sotechcllc/RFDoorLock/README.md

# RFDoorLock
Repo. for the RFID DoorLock project
