sotechcllc/RFDoorLock/Hardware/Diagrams/Circuit.png

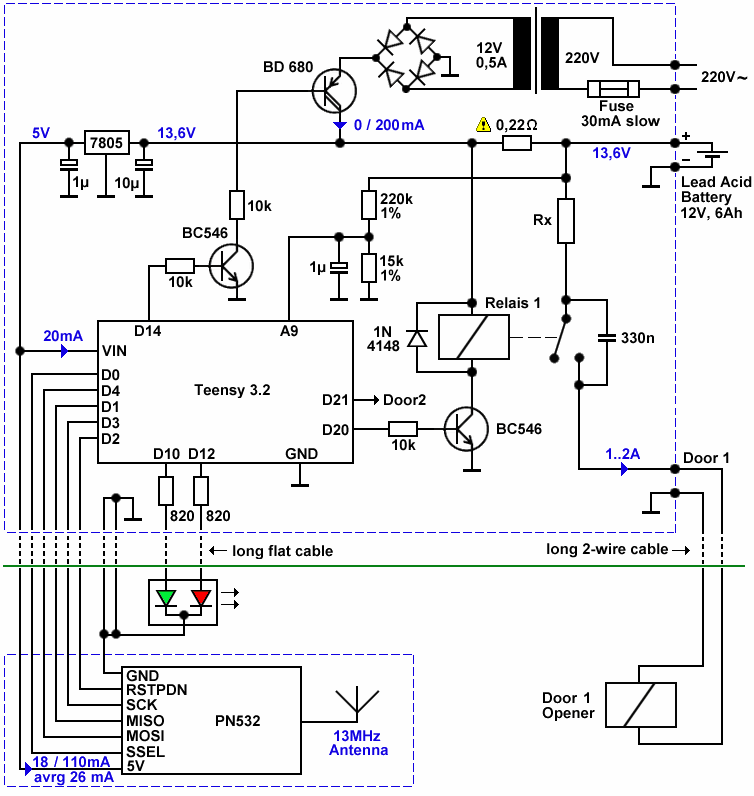
Hardware/Diagrams/Circuit.png
