sotechcllc/RFDoorLock/Hardware/Diagrams/Board for manual soldering/Board (Parts and Grid).png

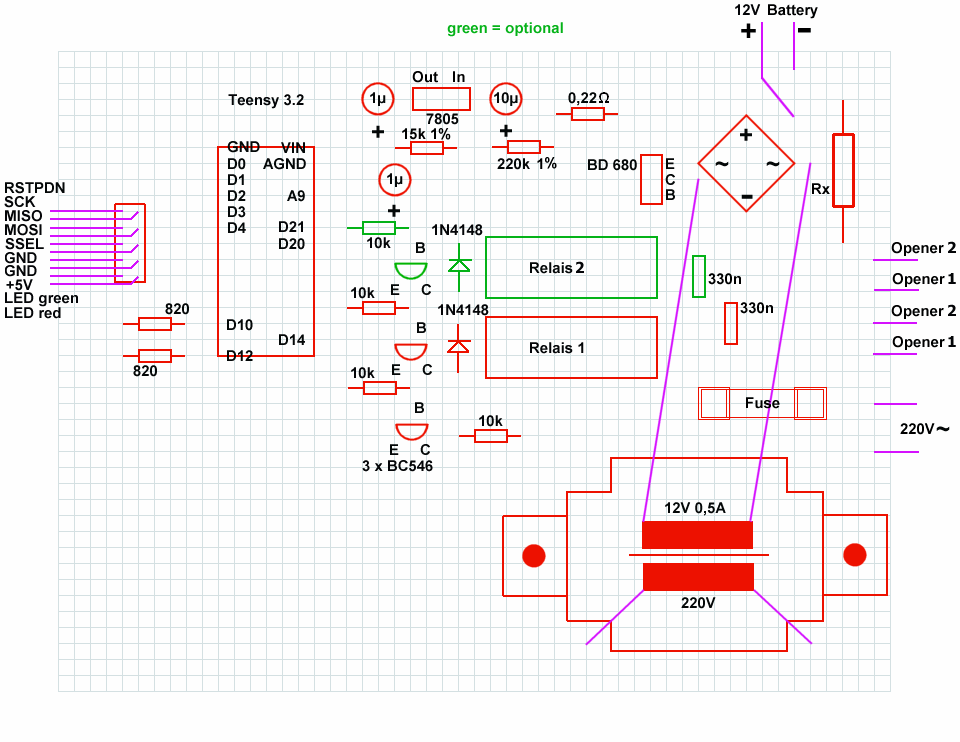
Hardware/Diagrams/Board for manual soldering/Board (Parts and Grid).png
