sotechcllc/RFDoorLock/Hardware/Diagrams/Board for manual soldering/Board (All).png

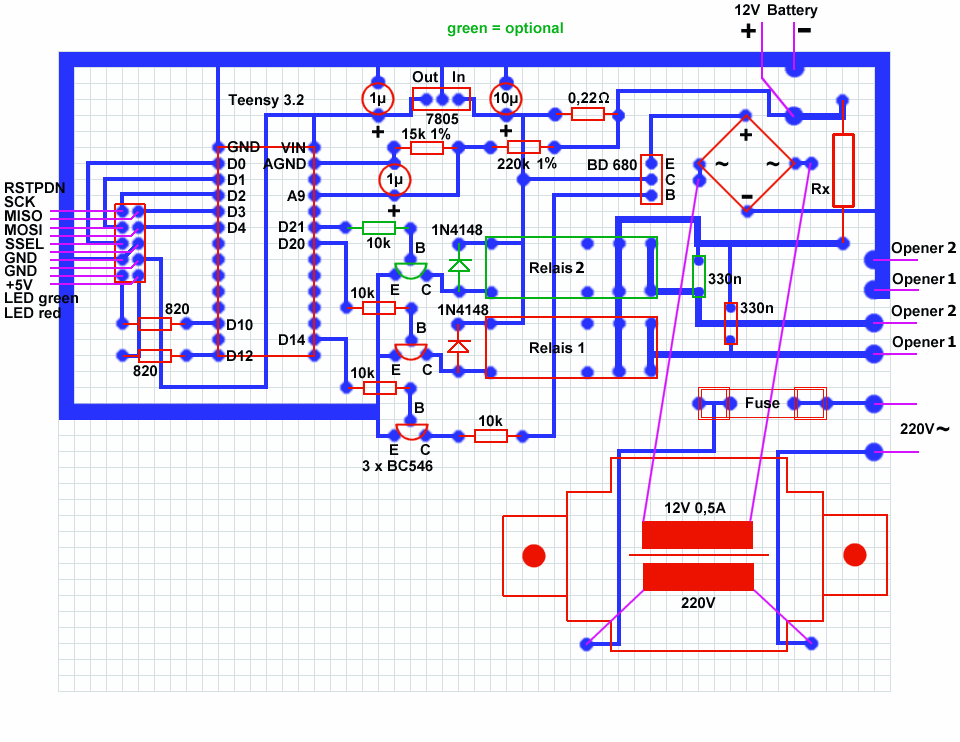
Hardware/Diagrams/Board for manual soldering/Board (All).png
