sotechcllc/RFDoorLock/Hardware/Diagrams/Board for manual soldering/Board (Pathway and Grid).png

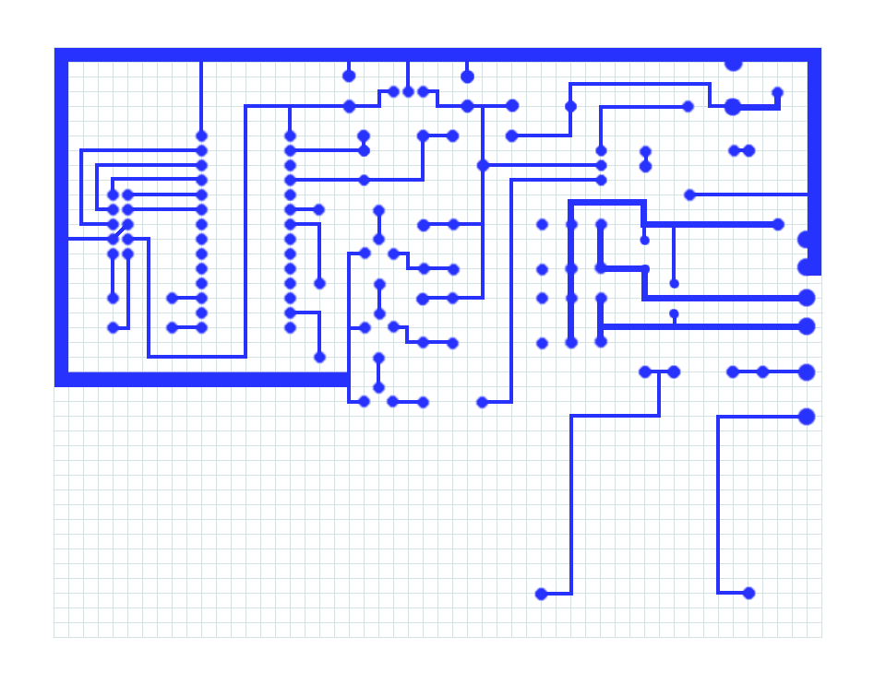
Hardware/Diagrams/Board for manual soldering/Board (Pathway and Grid).png
