sotechcllc/RFDoorLock/Hardware/Diagrams/Board for manual soldering/Board (Pathway only).png

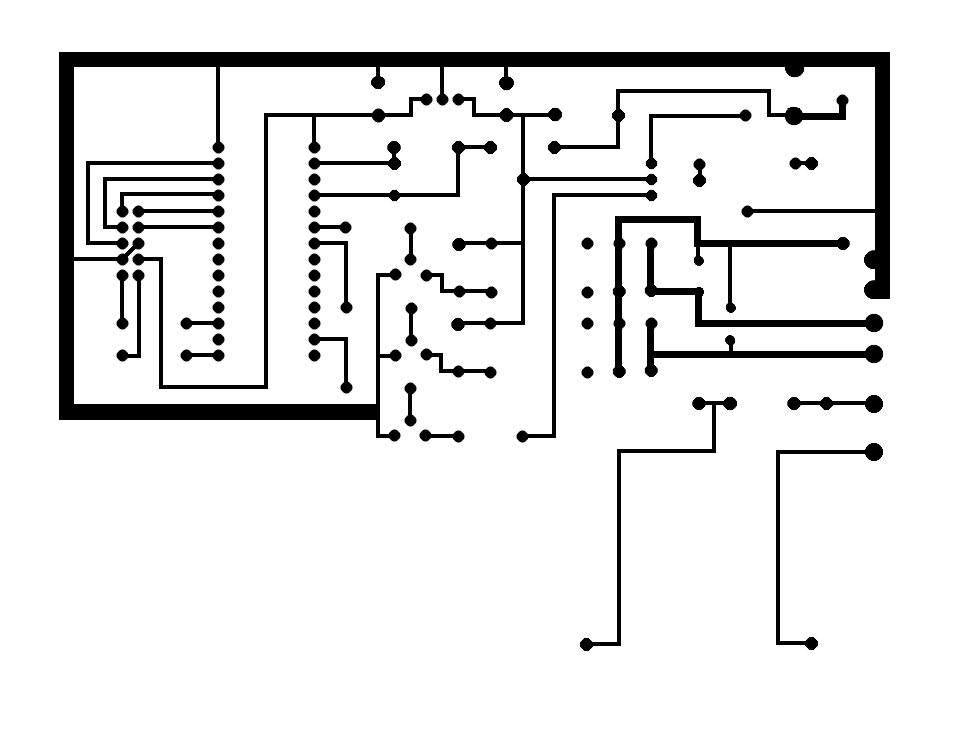
Hardware/Diagrams/Board for manual soldering/Board (Pathway only).png
