sotechcllc/RFDoorLock/Hardware/Diagrams/Board for PCB production (Eagle v7.6)/RFID-Lock.brd

## EAGLE design Hardware/Diagrams/Board for PCB production (Eagle v7.6)/RFID-Lock.brd (2017-03-13)

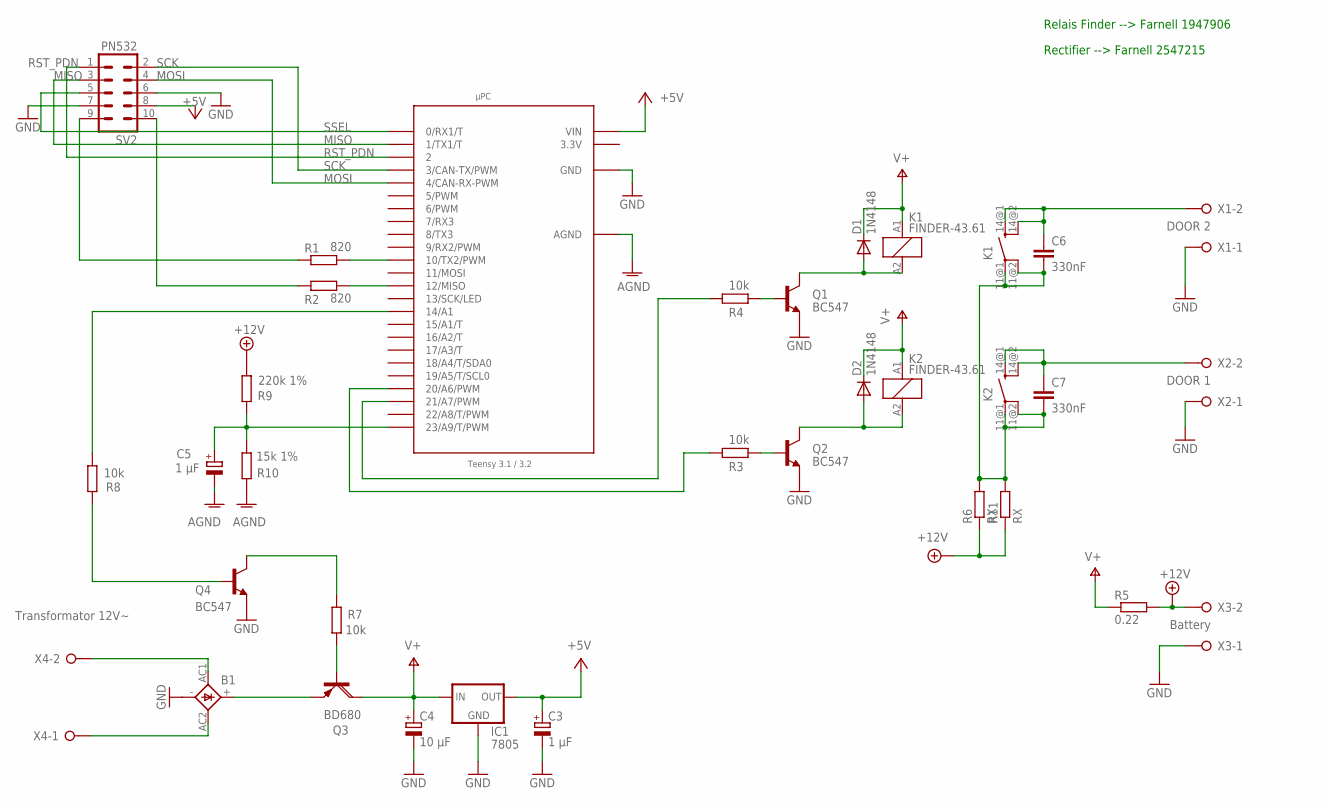
[picture p8: schematic RFID-Lock.sch]

Parts:
B1: GBPC6
C3, C5: 1 µF; E2,5-5
C4: 10 µF; E2,5-5
C6, C7: 330nF; C5B4.5
D1, D2: 1N4148; DO35-7
IC1: 7805; 78XXS
K1, K2: FINDER-43.61
Q1, Q2, Q4: BC547; TO92
Q3: BD680; TO126AV
R1, R2: 820; 0204/7
R3, R4, R7, R8: 10k; 0204/7
R5: 0.22; 0204/7
R6, R11: RX; P0613/15
R9: 220k 1%; 0204/7
R10: 15k 1%; 0204/7
SV2: PN532; MA05-2
X1: DOOR 2; W237-132
X2: DOOR 1; W237-132
X3: Battery; W237-132
X4: Transformator 12V~; W237-132
µPC: Teensy 3.1 / 3.2; TEENSY3-DIL

Connections:
3.3V: µPC.3.3V
+5V: C3.+, IC1.OUT, SV2.8, µPC.VIN
+12V: R5.2, R6.1, R9.2, R11.1, X3.2
AGND: C5.-, R10.1, µPC.AGND
DOOR2: C6.1, K1.14@1 (SA), K1.14@2 (SB), X1.2
GND: B1.-, C3.-, C4.-, IC1.GND, Q1.1 (E), Q2.1 (E), Q4.1 (E), SV2.6, SV2.7, X1.1, X2.1, X3.1, µPC.GND
LED-GREEN: R1.1, SV2.9
LED-RED: R2.1, SV2.10
MISO: SV2.3, µPC.1 (1/TX1/T)
MOSI: SV2.4, µPC.4 (4/CAN-RX-PWM)
unnamed: Q3.B, R7.1
unnamed: Q4.3 (C), R7.2
unnamed: R1.2, µPC.10 (10/TX2/PWM)
unnamed: R2.2, µPC.12 (12/MISO)
unnamed: B1.AC1, X4.2
unnamed: D2.A, K2.A2 (2), Q2.3 (C)
unnamed: Q4.2 (B), R8.1
unnamed: C7.1, K2.14@1 (SA), K2.14@2 (SB), X2.2
unnamed: D1.A, K1.A2 (2), Q1.3 (C)
unnamed: Q1.2 (B), R4.2
unnamed: Q2.2 (B), R3.2
unnamed: R4.1, µPC.21/A7 (21/A7/PWM)
unnamed: R3.1, µPC.20/A6 (20/A6/PWM)
unnamed: B1.+, Q3.E
unnamed: B1.AC2, X4.1
unnamed: C6.2, C7.2, K1.11@1 (PA), K1.11@2 (PB), K2.11@1 (PA), K2.11@2 (PB), R6.2, R11.2
unnamed: R8.2, µPC.14/A0 (14/A1)
unnamed: C5.+, R9.1, R10.2, µPC.23/A9 (23/A9/T/PWM)
RST_PDN: SV2.1, µPC.2
SCK: SV2.2, µPC.3 (3/CAN-TX/PWM)
SSEL: SV2.5, µPC.0 (0/RX1/T)
V+: C4.+, D1.C, D2.C, IC1.IN, K1.A1 (1), K2.A1 (1), Q3.C, R5.1

Notes on the sheet:
Relais Finder --> Farnell 1947906
Rectifier --> Farnell 2547215

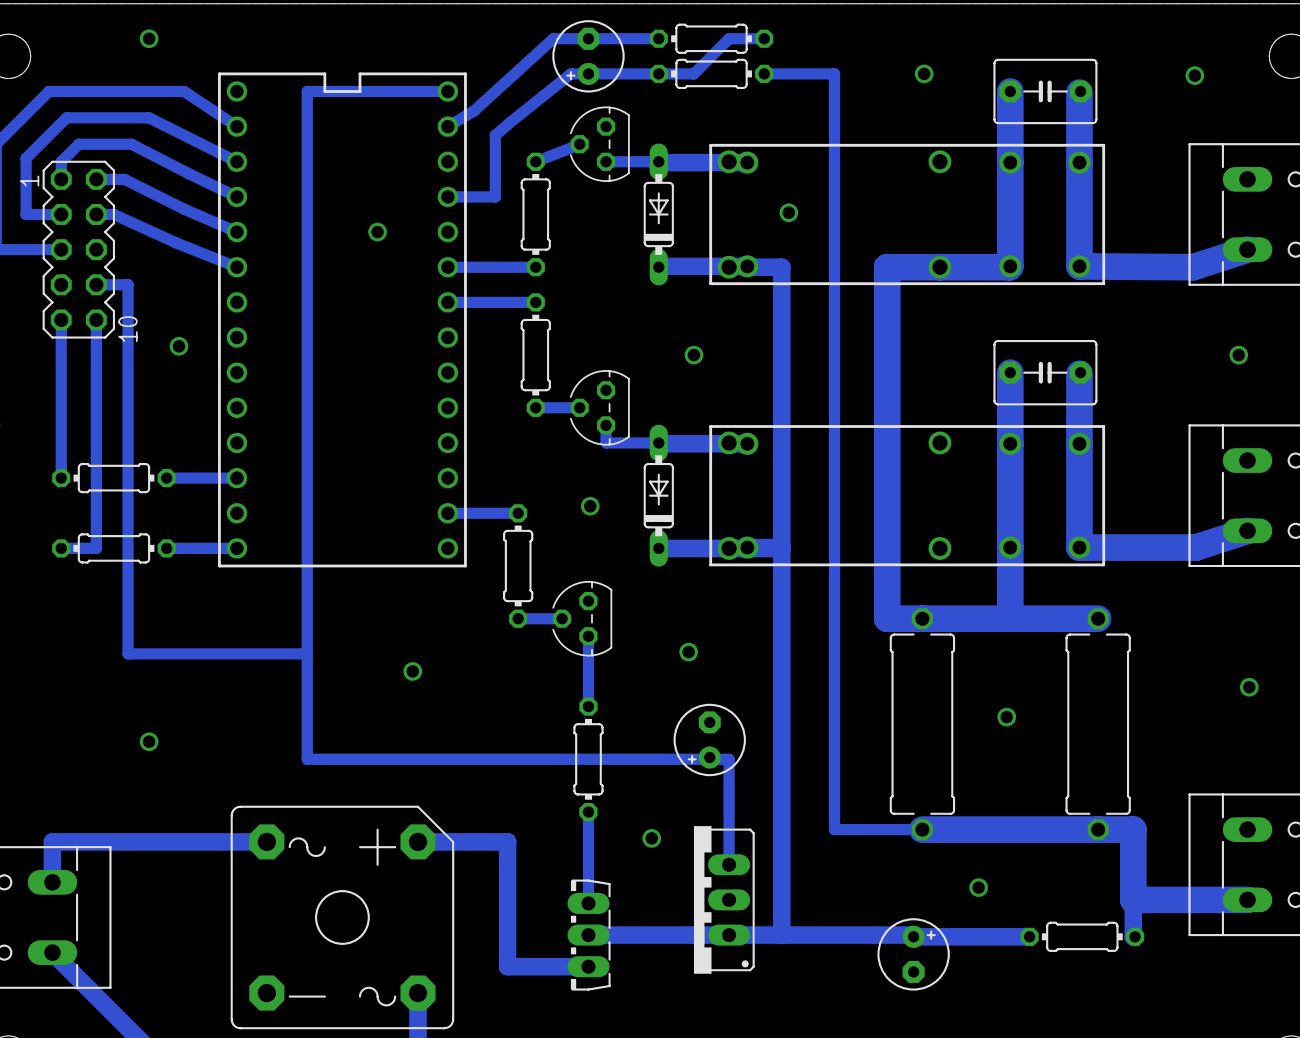
[picture p9: board RFID-Lock.brd from above]

Board: 2 copper layers, 32 parts (0 on the bottom side), 31 nets.
