sotechcllc/RFDoorLock/Software/WICED Feather/DoorOpenerSketchWICED/EEPROM.h

/*
  EEPROM.h - EEPROM library
  Version 1.0 Original Copyright (c) 2006 David A. Mellis.  All right reserved.
  Version 2.0 Copyright (c) 2015 Christopher Andrews.  All right reserved.
  This library is free software; you can redistribute it and/or
  modify it under the terms of the GNU Lesser General Public
  License as published by the Free Software Foundation; either
  version 2.1 of the License, or (at your option) any later version.
  This library is distributed in the hope that it will be useful,
  but WITHOUT ANY WARRANTY; without even the implied warranty of
  MERCHANTABILITY or FITNESS FOR A PARTICULAR PURPOSE.  See the GNU
  Lesser General Public License for more details.
  You should have received a copy of the GNU Lesser General Public
  License along with this library; if not, write to the Free Software
  Foundation, Inc., 51 Franklin St, Fifth Floor, Boston, MA  02110-1301  USA
*/

#if defined(__AVR__) && !defined(EEPROM_h)
  #define EEPROM_h

#ifndef Arduino_h  //These includes are available through Arduino.h
  #include <inttypes.h>
  #include <avr/io.h>
#endif
#include <avr/eeprom.h>

/***
    This provides a method of generating compile time errors in C++98 (#error is unsuitable).
    C++11 includes static_assert as a language construct.
***/
#if __cplusplus < 201103L || !defined(__GXX_EXPERIMENTAL_CXX0X__)
  #ifndef static_assert
    namespace COMPILE{
      template< bool > struct ERROR;
      template<> struct ERROR< true >{};
    };
    #define static_assert( cond, msg ) { COMPILE::ERROR<!!(cond)> msg; (void) msg; }    
  #endif
#else
  #define READING_POINTERS_DISABLED_FOR_EEPROM_GET  "Storing or reading a single pointer object has been disabled in EEPROM.get() and EEPROM.put(). " \
                                                    "Add a third parameter (count of elements) to use put() and get() on blocks of data. "            \
                                                    "The count is 'elements' not bytes of data."
  #define STORING_POINTERS_DISABLED_FOR_EEPROM_PUT READING_POINTERS_DISABLED_FOR_EEPROM_GET
#endif

/***
    EERef class.
    
    This object references an EEPROM cell.
    Its purpose is to mimic a typical byte of RAM, however its storage is the EEPROM.
    This class has an overhead of two bytes, similar to storing a pointer to an EEPROM cell.
***/

struct EEBit; //Forward declaration for EERef::opreator[]
struct EEPtr; //Forward declaration for EERef::opreator&

struct EERef{

    template< typename T > EERef( T *ptr ) : index( (int) ptr ) {}
    EERef( const int index ) : index( index )                   {}
    
    //Access/read members.
    uint8_t operator*() const            { return eeprom_read_byte( (uint8_t*) index ); }
    operator const uint8_t() const       { return **this; }
    EEBit operator[]( const int bidx );  //Defined below EEBit
    EEPtr operator&() const;             //Defined below EEPtr
    
    //Assignment/write members.
    EERef &operator=( const EERef &ref ) { return *this = *ref; }
    EERef &operator=( uint8_t in )       { return eeprom_write_byte( (uint8_t*) index, in ), *this; }
    EERef &operator +=( uint8_t in )     { return *this = **this + in; }
    EERef &operator -=( uint8_t in )     { return *this = **this - in; }
    EERef &operator *=( uint8_t in )     { return *this = **this * in; }
    EERef &operator /=( uint8_t in )     { return *this = **this / in; }
    EERef &operator ^=( uint8_t in )     { return *this = **this ^ in; }
    EERef &operator %=( uint8_t in )     { return *this = **this % in; }
    EERef &operator &=( uint8_t in )     { return *this = **this & in; }
    EERef &operator |=( uint8_t in )     { return *this = **this | in; }
    EERef &operator <<=( uint8_t in )    { return *this = **this << in; }
    EERef &operator >>=( uint8_t in )    { return *this = **this >> in; }
    
    EERef &update( uint8_t in )          { return  in != *this ? *this = in : *this; }
    
    /** Prefix increment/decrement **/
    EERef& operator++()                  { return *this += 1; }
    EERef& operator--()                  { return *this -= 1; }
    
    /** Postfix increment/decrement **/
    uint8_t operator++ (int){ 
        uint8_t ret = **this;
        return ++(*this), ret;
    }

    uint8_t operator-- (int){ 
        uint8_t ret = **this;
        return --(*this), ret;
    }
    
    int index; //Index of current EEPROM cell.
};

/***
    EEBit class.
    
    This object is a reference object similar to EERef, however it references
    only a single bit. Its function mimics a bool type.
***/

struct EEBit{

    //Constructor, use by passing in index of EEPROM byte, then index of bit to read.
    EEBit( int index, uint8_t bidx ) 
        : ref( index ), mask( 0x01 << bidx ) {}

    //Modifier functions.
    EEBit &setIndex( uint8_t bidx )          { return mask = (0x01 << bidx), *this; }
    EEBit &set()                             { return *this = true; }
    EEBit &clear()                           { return *this = false; }
    
    //Read/write functions.
    operator const bool() const              { return ref & mask; }
    EEBit &operator =( const EEBit &copy )   { return *this = ( const bool ) copy; }
    
    EEBit &operator =( const bool &copy ){
        if( copy )  ref |= mask;
        else  ref &= ~mask;
        return *this;
    }

    EERef ref;     //Reference to EEPROM cell.
    uint8_t mask;  //Mask of bit to read/write.
};

inline EEBit EERef::operator[]( const int bidx ) { return EEBit( index, bidx ); } //Deferred definition till EEBit becomes available.

/***
    EEPtr class.
    
    This object is a bidirectional pointer to EEPROM cells represented by EERef objects.
    Just like a normal pointer type, this can be dereferenced and repositioned using 
    increment/decrement operators.
***/

struct EEPtr{

    template< typename T > EEPtr( T *ptr ) : index( (int) ptr ) {}    
    EEPtr( const int index ) : index( index )                    {}
        
    //Pointer read/write.
    operator const int() const          { return index; }
    EEPtr &operator=( int in )          { return index = in, *this; }
    EERef operator[]( int idx )         { return index + idx; }
    
    //Dreference & member access.
    EERef operator*()                   { return index; }
    EERef *operator->()                 { return (EERef*) this; }    
    
    //Iterator functionality.
    bool operator!=( const EEPtr &ptr ) { return index != ptr.index; }
    EEPtr& operator+=( int idx )        { return index += idx, *this; }
    EEPtr& operator-=( int idx )        { return index -= idx, *this; }    
    
    /** Prefix & Postfix increment/decrement **/
    EEPtr& operator++()                 { return ++index, *this; }
    EEPtr& operator--()                 { return --index, *this; }
    EEPtr operator++ (int)              { return index++; }
    EEPtr operator-- (int)              { return index--; }

    int index; //Index of current EEPROM cell.
};

inline EEPtr EERef::operator&() const { return index; } //Deferred definition till EEPtr becomes available.

/***
    EEPROMClass class.
    
    This object represents the entire EEPROM space.
    It wraps the functionality of EEPtr and EERef into a basic interface.
    This class is also 100% backwards compatible with earlier Arduino core releases.
***/

class EEPROMClass{
  protected:
    /*** IsPointer can allow generic template functions to discriminate based on whether a template type is a pointer. ***/
    template <class U> struct IsPointer{ enum{ result = false }; };      //Not a pointer.
    template <class U> struct IsPointer<U*>{ enum{ result = true }; };   //A standard pointer.
    template <class U> struct IsPointer<U*&>{ enum{ result = true }; };  //A reference to a pointer (is still considered a pointer in usage due to reference semantics).      
  public:
    //Basic user access methods.
    EERef operator[]( EERef ref )         { return ref; }
    EERef read( EERef ref )               { return ref; }
    void write( EERef ref, uint8_t val )  { ref = val; }
    void update( EERef ref, uint8_t val ) { ref.update( val ); }
    
    //Bit access methods.
    EEBit readBit( EERef ref, uint8_t bidx )                 { return ref[ bidx ]; }
    void writeBit( EERef ref, uint8_t bidx, const bool val ) { ref[ bidx ] = val; }
    
    //STL and C++11 iteration capability.
    EEPtr begin()                        { return 0x00; }
    EEPtr end()                          { return length(); } //Standards requires this to be the item after the last valid entry. The returned pointer is invalid.
    
    //Properties and state.
    uint16_t length()                    { return E2END + 1; }
    const bool ready()                   { return eeprom_is_ready(); }
    
    //Functionality to 'get' objects, arrays, or memory blocks from the EEPROM.
    template< typename T > T &get( EEPtr ptr, T &t ){
        static_assert( !IsPointer<T>::result, READING_POINTERS_DISABLED_FOR_EEPROM_GET ); //Error handling: prevent a user from trying to get/put pointer types.
        return get( ptr, (uint8_t*) &t, sizeof(T) ), t;
    }
    
    template< typename T, int N > T (&get( EEPtr ptr, T (&t)[N] ))[N] { return get( ptr, (uint8_t*) t, N * sizeof(T) ), t; }
    template< typename T > void get( EEPtr ptr, T *t, int length )    { get( ptr, (uint8_t*) t, length * sizeof(T) ); }
    void get( EEPtr ptr, uint8_t *t, int length )                     { for( ; length ; --length, ++ptr ) *t++ = *ptr; }    
    
    //Functionality to 'put' objects, arrays, and memory blocks into the EEPROM.
    template< typename T > const T &put( EEPtr ptr, const T &t ){
        static_assert( !IsPointer<T>::result, STORING_POINTERS_DISABLED_FOR_EEPROM_PUT ); //Error handling: prevent a user from trying to get/put pointer types.
        return put( ptr, (uint8_t*) &t, sizeof(T) ), t;
    }

    template< typename T, int N > const T (&put( EEPtr ptr, const T (&t)[N] ))[N]  { return put( ptr, (uint8_t*) t, N * sizeof(T) ), t; }
    template< typename T > void put( EEPtr ptr, const T *t, int length )           { put( ptr, (uint8_t*) t, length * sizeof(T) ); }
    void put( EEPtr ptr, const uint8_t *t, int length )                            { for( ; length ; --length, ++ptr ) (*ptr).update( *t++ ); }       
};
static EEPROMClass EEPROM;
#endif
