sotechcllc/RFDoorLock/(commit log)

2017-03-13 Uploaded all the documentation related to the door lock project on a teensy 3.2 module.
    [RFID-Lock.brd, RFID-Lock.sch]
2017-03-13 Updated the libraries and added content for the WICED feather board.
    [RFID-Lock.brd, RFID-Lock.sch]
