sotechcllc/RFDoorLock/(notices)

Notices in the files:
Software/WICED Feather/DoorOpenerSketchWICED/Desfire.cpp:
Free Software Foundation, either version 3 of the License, or (at your
